theapi/gard_hw/README.md

# GARD STM32 Hardware

The Garden Animal Repellent Device built with an  STM32L053C8Tx and LoRa RFM95 module.

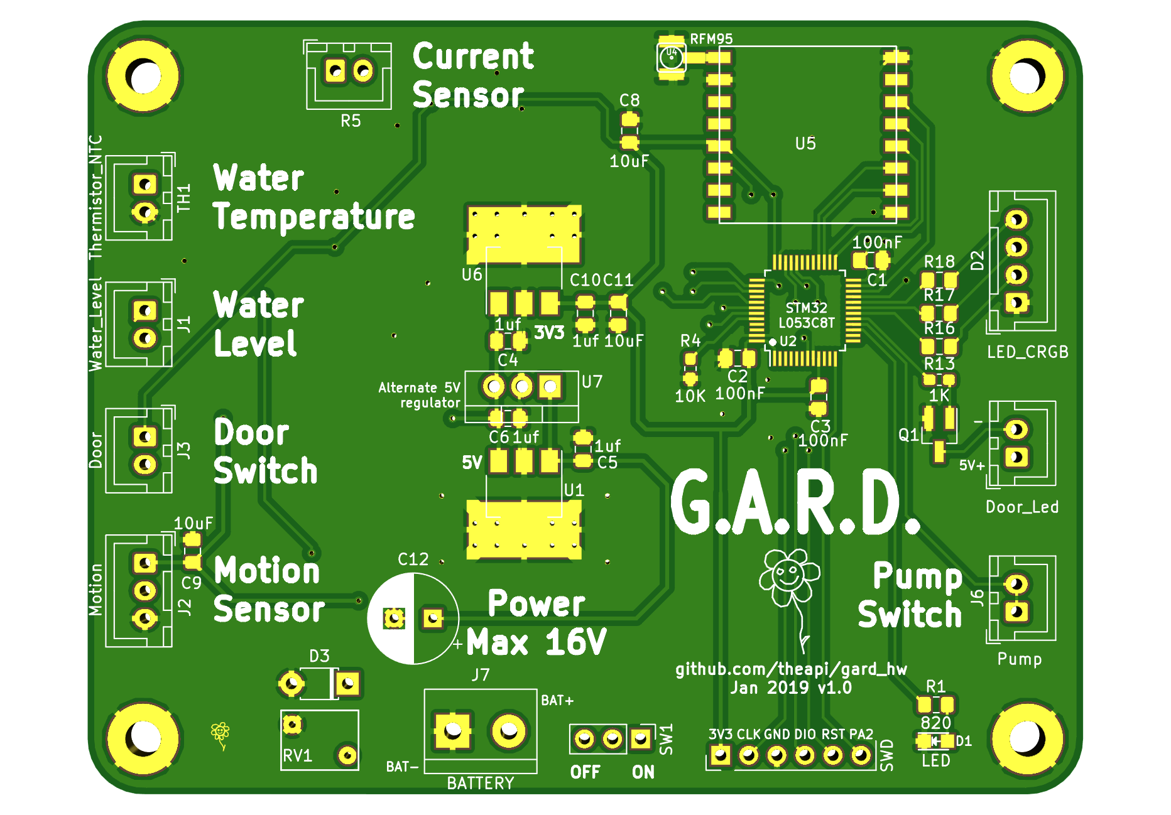
[picture p1: board.png]
