theapi/gard_hw/kicad/stm32l053c.pdf

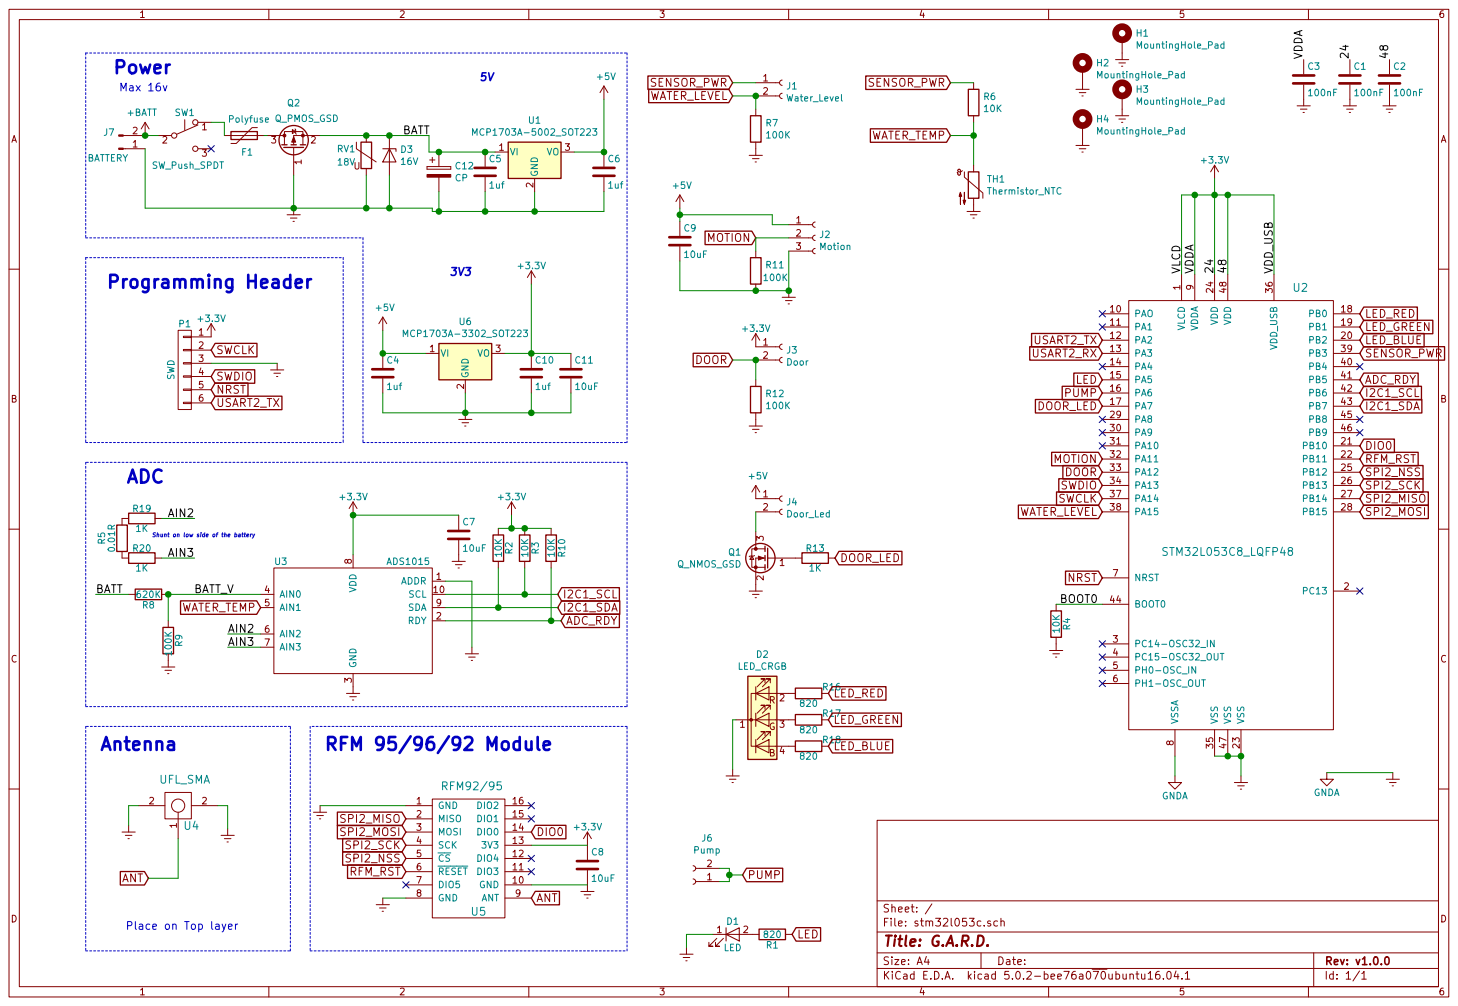
[picture p5: page 1]

9 PAO 10 PB2 20 PA9 30 PB4 40 PA1 11 PB10 21 PA10 31 PB5 41 PA2 12 PB11 22 PA11 32 PB6 42 PA3 13 VSS 23 PA12 33 PB7 43 PA4 14 VDD 24 PA13 34 BOOT0 44 PA5 15 PB12 25 VSS 35 PB8 45 PA6 16 PB13 26 VDD_USB 36 PB9 46 PA7 17 PB14 27 PA14 37 VSS 47 PB0 18 PB15 28 PA15 38 VDD 48 PB1 19 PA8 29 PB3 39 U2 STM32L053C8_LQFP48 10K R4 R1

8 SDA 9 SCL 10 U3 ADS1015 ANT Antenna RFM 95/96/92 Module

Id: 1/1 Title: G.A.R.D. File: stm32l053c.sch Sheet: /

Place on Top layer
