theapi/gard_hw/kicad/solder_mask.pdf

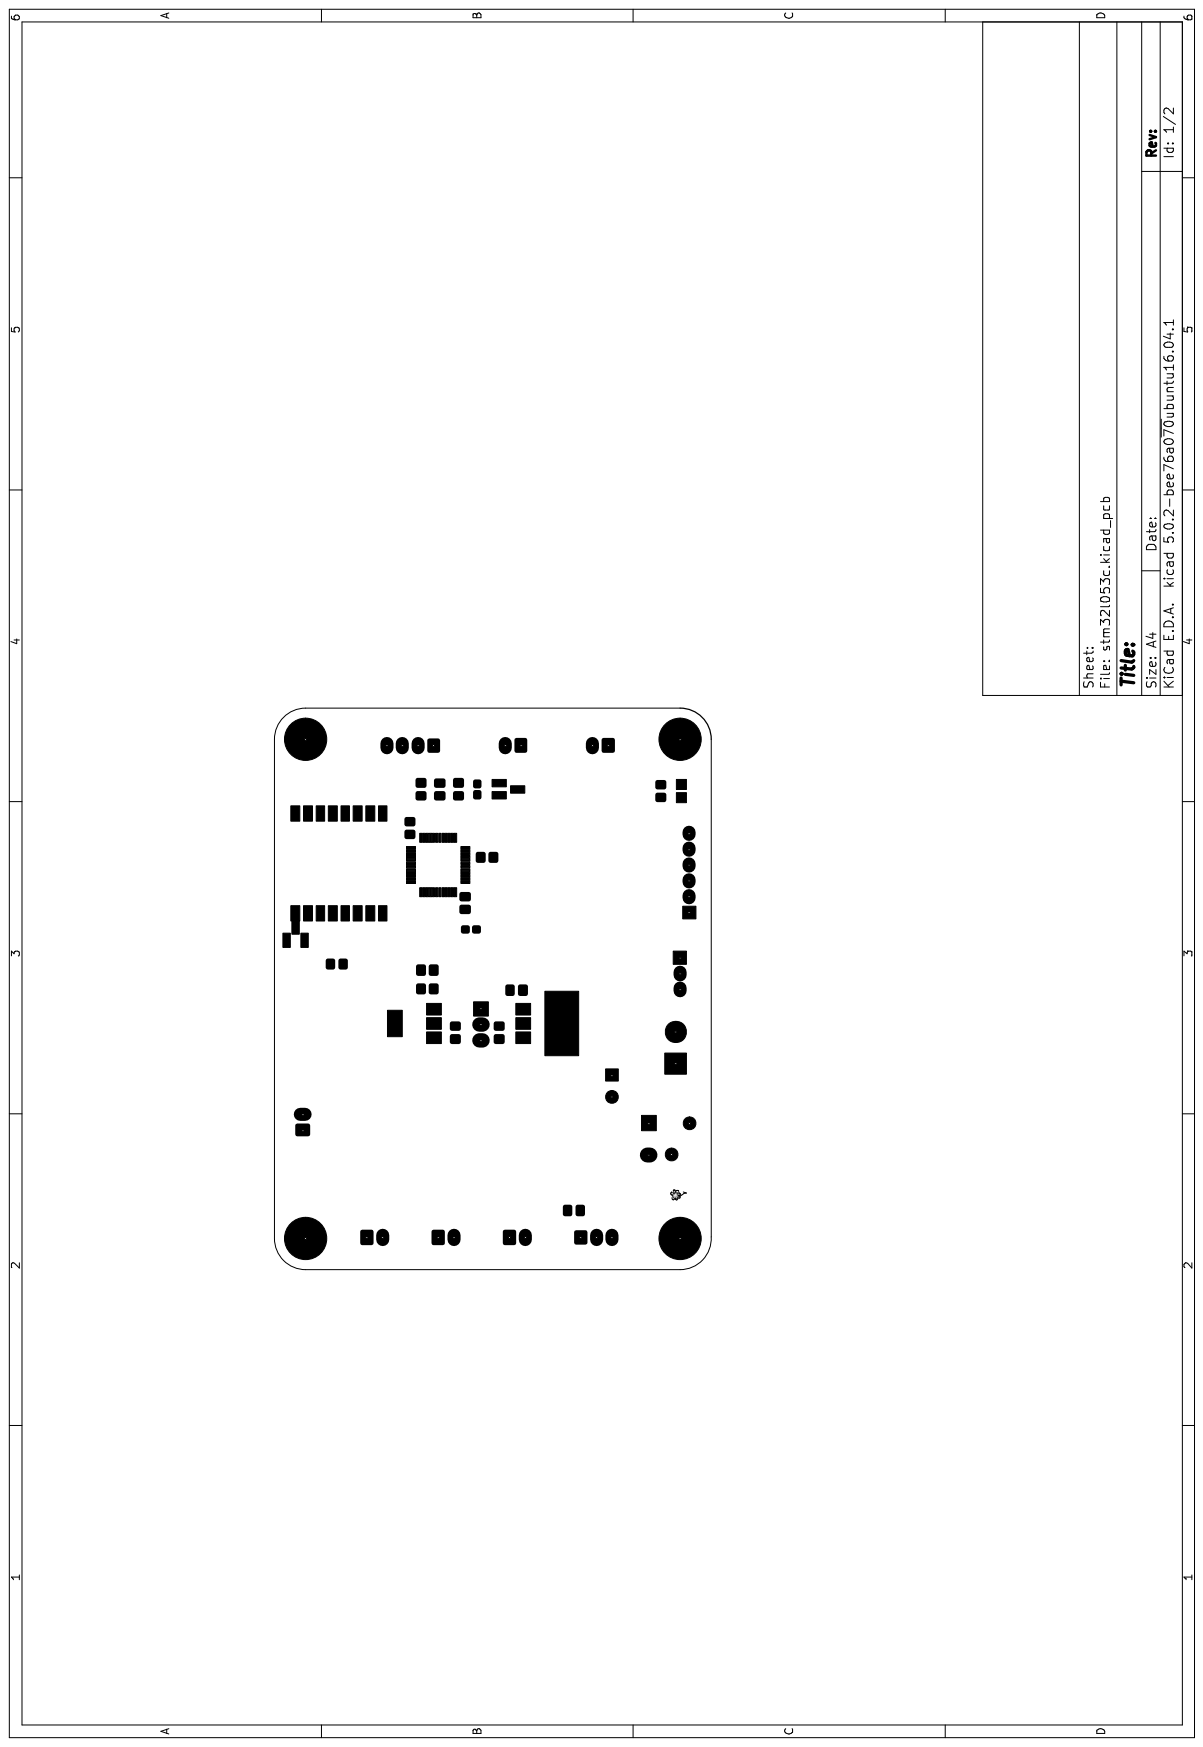
[picture p6: page 1]

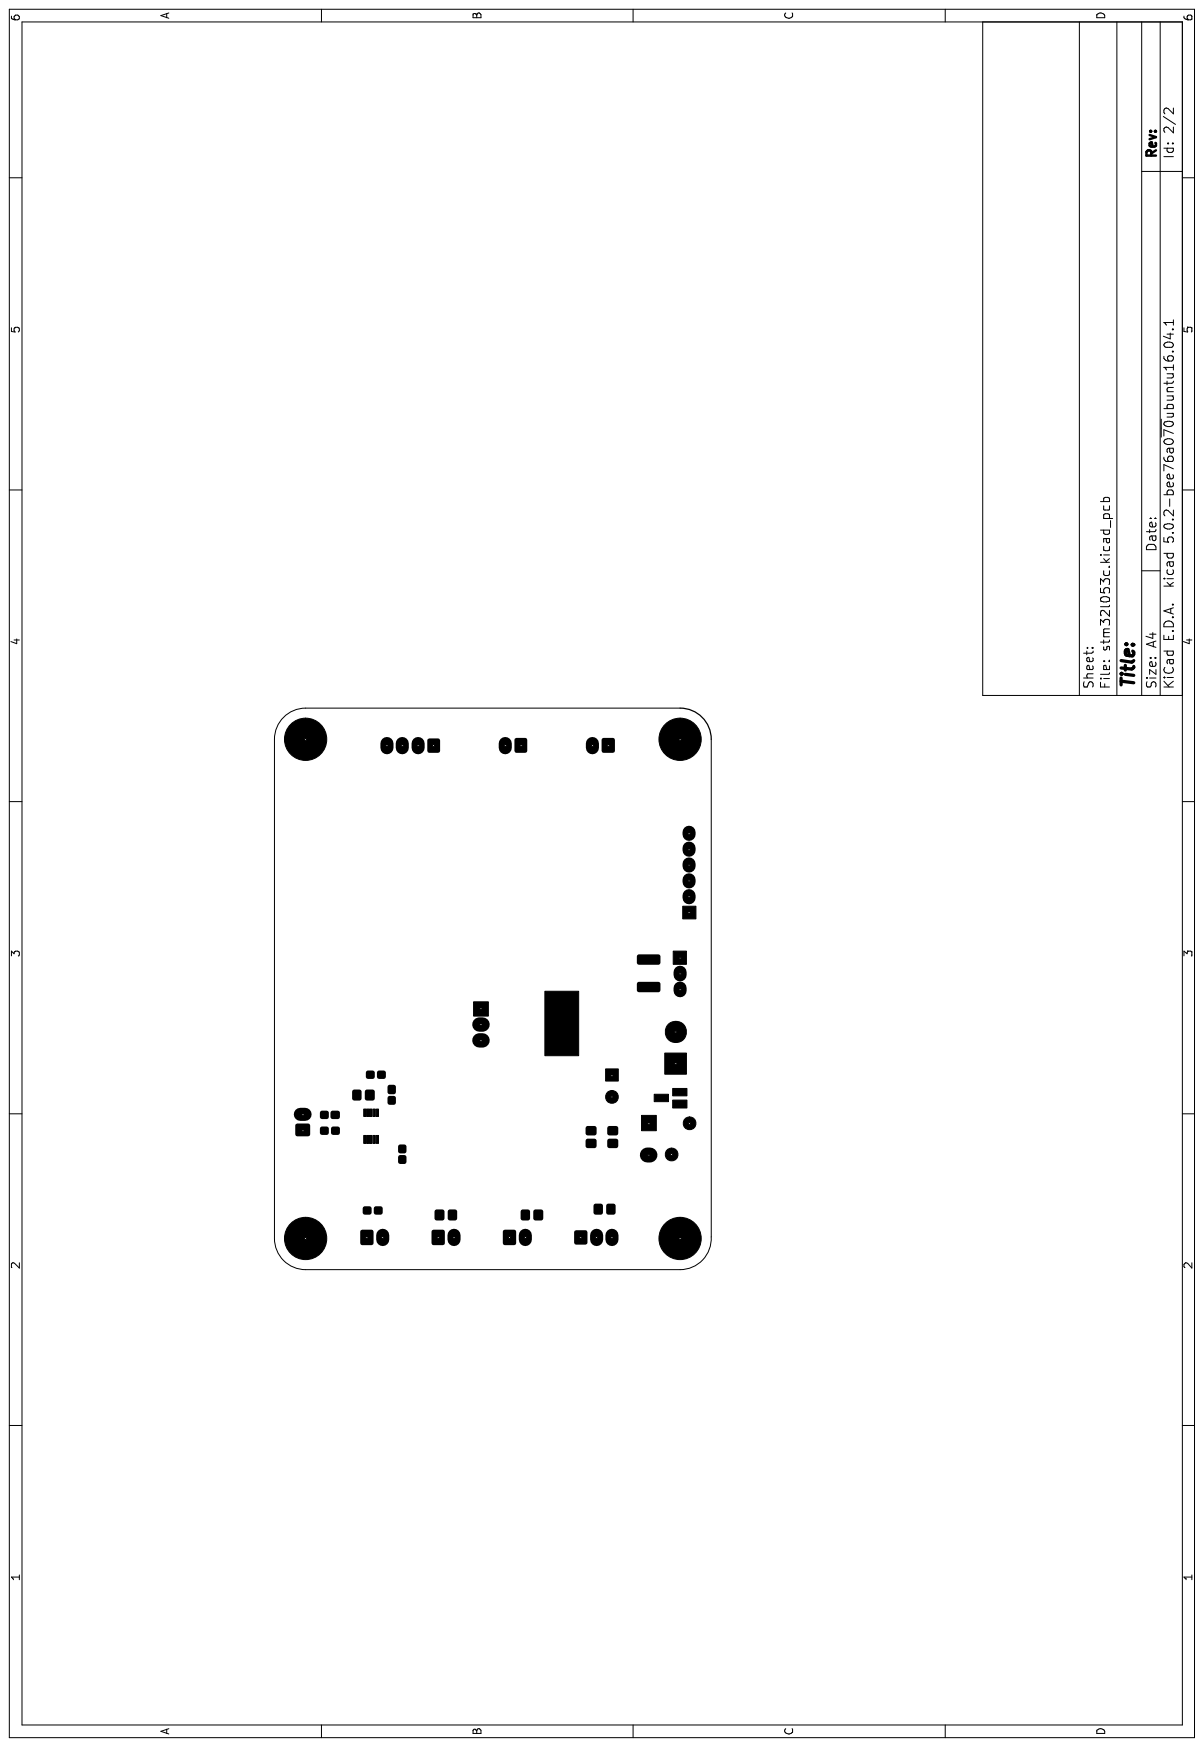
[picture p7: page 2]
