theapi/gard_hw/kicad/stm32l053c.kicad_pcb

## KiCad design kicad/stm32l053c.kicad_pcb (2019-01-03)

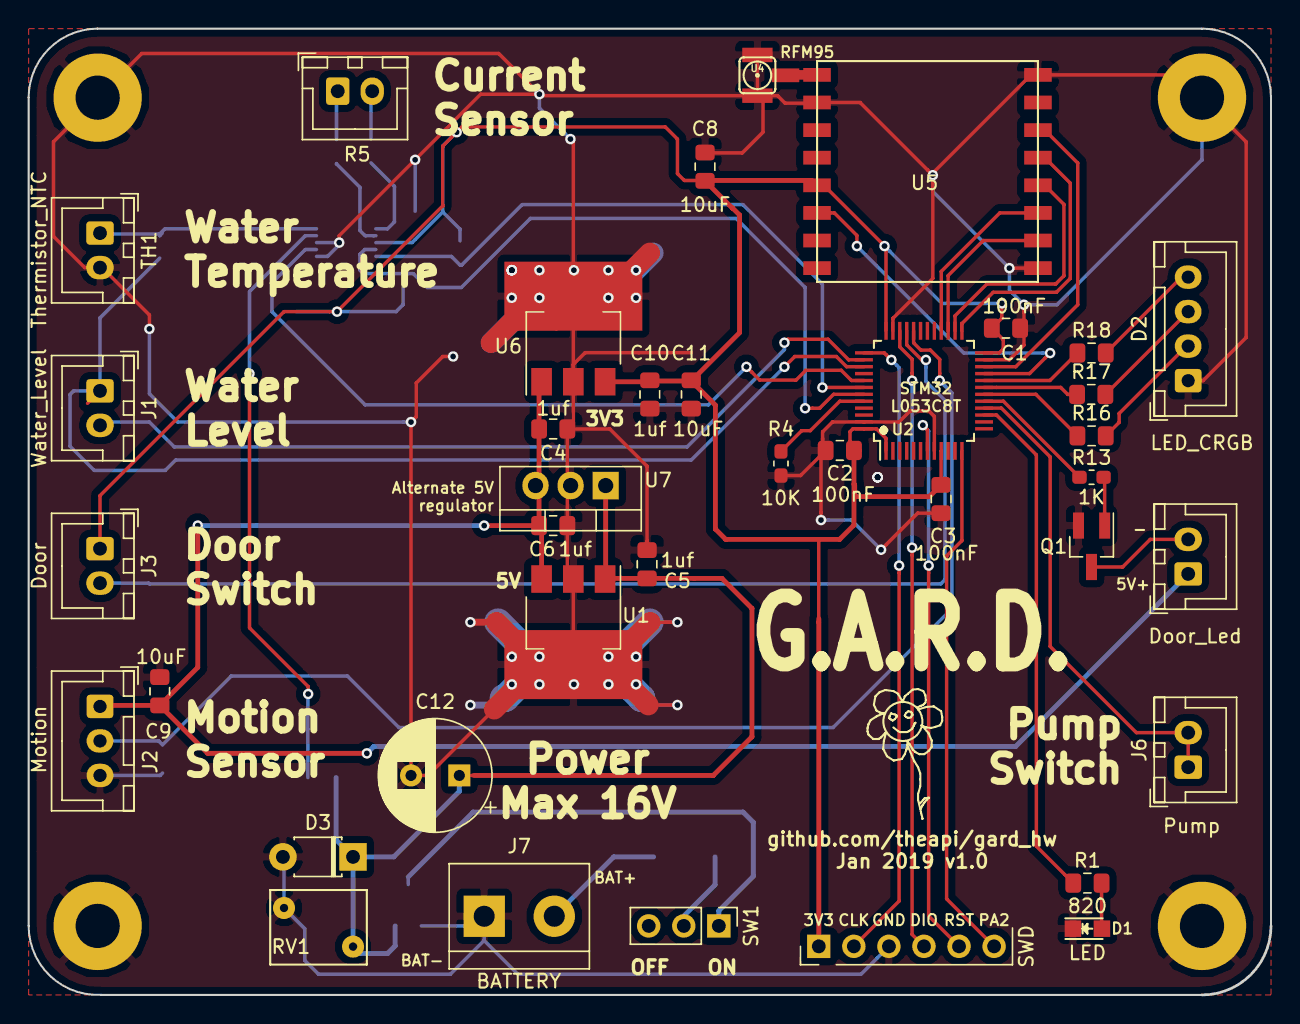
[picture p8: board stm32l053c.kicad_pcb from above]

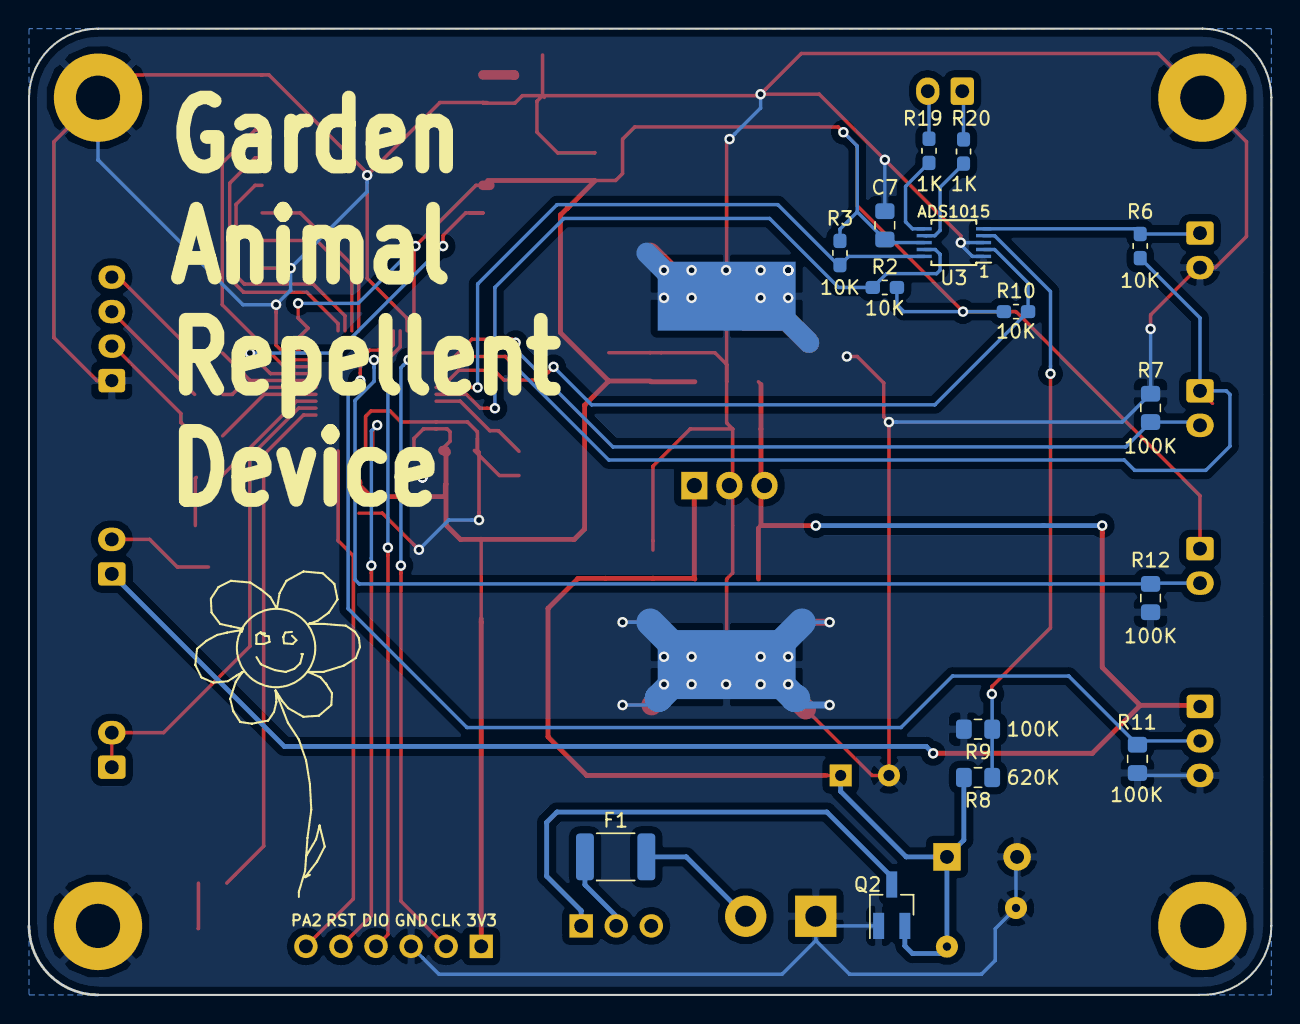
[picture p9: board stm32l053c.kicad_pcb from below]

Board: 2 copper layers, 90.0 x 70.0 mm, 57 parts (15 on the bottom side), 44 nets.

Parts:
C1, C2, C3: 100nF; C_0805_2012Metric_Pad1.15x1.40mm_HandSolder
C4, C5, C6, C10: 1uf; C_0805_2012Metric_Pad1.15x1.40mm_HandSolder
C7, C8, C9, C11: 10uF; C_0805_2012Metric_Pad1.15x1.40mm_HandSolder
C12: CP; CP_Radial_D8.0mm_P3.50mm
D1: LED; LED_0805
D2: LED_CRGB; JST_XH_B04B-XH-A_1x04_P2.50mm_Vertical
D3: 16V; D_T-1_P5.08mm_Horizontal
F1: Polyfuse; R_1812_4532Metric_Pad1.30x3.40mm_HandSolder
H1, H2, H3, H4: MountingHole_Pad; MountingHole_3.2mm_M3_Pad
J1: Water_Level; JST_XH_B02B-XH-A_1x02_P2.50mm_Vertical
J2: Motion; JST_XH_B03B-XH-A_1x03_P2.50mm_Vertical
J3: Door; JST_XH_B02B-XH-A_1x02_P2.50mm_Vertical
J4: Door_Led; JST_XH_B02B-XH-A_1x02_P2.50mm_Vertical
J6: Pump; JST_XH_B02B-XH-A_1x02_P2.50mm_Vertical
J7: BATTERY; TerminalBlock_bornier-2_P5.08mm
P1: SWD; Pin_Header_Straight_1x06_Pitch2.54mm
Q1: Q_NMOS_GSD; SOT-23_Handsoldering
Q2: Q_PMOS_GSD; SOT-23_Handsoldering
R1, R16, R17, R18: 820; R_0805_2012Metric_Pad1.15x1.40mm_HandSolder
R2, R3, R4, R6, R10: 10K; R_0603_1608Metric_Pad1.05x0.95mm_HandSolder
R5: 0.01R; JST_XH_B02B-XH-A_1x02_P2.50mm_Vertical
R7, R9, R11, R12: 100K; R_0805_2012Metric_Pad1.15x1.40mm_HandSolder
R8: 620K; R_0805_2012Metric_Pad1.15x1.40mm_HandSolder
R13, R19, R20: 1K; R_0603_1608Metric_Pad1.05x0.95mm_HandSolder
RV1: 18V; RV_Disc_D7mm_W5.4mm_P5mm
SW1: SW_Push_SPDT; PinHeader_1x03_P2.54mm_Vertical
TH1: Thermistor_NTC; JST_XH_B02B-XH-A_1x02_P2.50mm_Vertical
U1: MCP1703A-5002_SOT223; SOT-223-3_TabPin2_heatsink
U2: STM32L053C8_LQFP48; LQFP-48_7x7mm_Pitch0.5mm
U3: ADS1015; TSSOP-10_3x3mm_P0.5mm
U4: UFL_SMA; coaxial_u.fl-r-smt-1
U5: RFM92/95; RFM92_95_96_98
U6: MCP1703A-3302_SOT223; SOT-223-3_TabPin2_heatsink
U7: LP2954_TO220; TO-220-3_Vertical

Connections:
+3V3: C1.1, C2.1, C3.1, C7.1, C8.1, C10.1, C11.1, J3.1, P1.1, R2.1, R3.1, R10.1, U2.1, U2.9, U2.24, U2.36, U2.48, U3.8, U5.13, U6.3
+5V: C4.1, C6.1, C9.1, J2.1, J4.1, U1.3, U6.1, U7.3
+BATT: F1.2, J7.2
/AIN2: R19.1, U3.6
/AIN3: R20.1, U3.7
/BATT: C5.1, C12.1, D3.1, Q2.2, R8.2, RV1.1, U1.1, U7.1
/BATT_V: R8.1, R9.1, U3.4
/BOOT0: R4.1, U2.44
ADC_RDY: R10.2, U2.41, U3.2
ANT: U4.1, U5.9
DIO0: U2.21, U5.14
DOOR: J3.2, R12.1, U2.33
DOOR_LED: R13.1, U2.17
Earth: C1.2, C2.2, C3.2, C4.2, C5.2, C6.2, C7.2, C8.2, C9.2, C10.2, C11.2, C12.2, D1.1, D2.1, D3.2, H1.1, H2.1, H3.1, H4.1, J2.3, J7.1, P1.3, Q1.2, Q2.1, R4.2, R7.2, R9.2, R11.2, R12.2, RV1.2, TH1.2, U1.2, U2.8, U2.23, U2.35, U2.47, U3.1, U3.3, U4.2, U5.1, U5.8, U5.10, U6.2, U7.2
I2C1_SCL: R3.2, U2.42, U3.10
I2C1_SDA: R2.2, U2.43, U3.9
LED: R1.1, U2.15
LED_BLUE: R18.1, U2.20
LED_GREEN: R17.1, U2.19
LED_RED: R16.1, U2.18
MOTION: J2.2, R11.1, U2.32
NRST: P1.5, U2.7
unnamed: D1.2, R1.2
unnamed: D2.2, R16.2
unnamed: D2.3, R17.2
unnamed: D2.4, R18.2
unnamed: F1.1, SW1.2
unnamed: J4.2, Q1.3
unnamed: Q1.1, R13.2
unnamed: Q2.3, SW1.1
unnamed: R5.2, R19.2
unnamed: R5.1, R20.2
PUMP: J6.1, J6.2, U2.16
RFM_RST: U2.22, U5.6
SENSOR_PWR: J1.1, R6.1, U2.39
SPI2_MISO: U2.27, U5.2
SPI2_MOSI: U2.28, U5.3
SPI2_NSS: U2.25, U5.5
SPI2_SCK: U2.26, U5.4
SWCLK: P1.2, U2.37
SWDIO: P1.4, U2.34
USART2_TX: P1.6, U2.12
WATER_LEVEL: J1.2, R7.1, U2.38
WATER_TEMP: R6.2, TH1.1, U3.5
