theapi/gard_hw/stm32/pump_controller/Src/main.c

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

/* Includes ------------------------------------------------------------------*/
#include "main.h"
#include "adc.h"
#include "i2c.h"
#include "rtc.h"
#include "spi.h"
#include "usart.h"
#include "gpio.h"

/* USER CODE BEGIN Includes */

#include "string.h"
#include "stdio.h"
#include "stdlib.h"

#include "battery.h"
#include "water.h"

/* USER CODE END Includes */

/* USER CODE BEGIN PD */

#define TXBUFFERSIZE 128

/* USER CODE END PD */


void SystemClock_Config(void);
static void MX_NVIC_Init(void);
/* USER CODE BEGIN 0 */

/* Buffer used for debug UART */
char tx_buffer[TXBUFFERSIZE];
uint32_t last_blink = 0;
/* tmp */
uint8_t msg_id = 0;
float water_temperature = 0;

/* USER CODE END 0 */

/**
  * @brief  The application entry point.
  * @retval int
  */
int main(void)
{
  /* MCU Configuration--------------------------------------------------------*/

  /* Reset of all peripherals, Initializes the Flash interface and the Systick. */
  HAL_Init();

  /* Configure the system clock */
  SystemClock_Config();

  /* Initialize all configured peripherals */
  MX_GPIO_Init();
  MX_ADC_Init();
  MX_I2C1_Init();
  MX_RTC_Init();
  MX_SPI2_Init();
  MX_USART2_UART_Init();

  /* Initialize interrupts */
  MX_NVIC_Init();
  /* USER CODE BEGIN 2 */

  HAL_GPIO_WritePin(GPIOB, SENSOR_PWR_Pin, GPIO_PIN_SET);

  HAL_GPIO_WritePin(GPIOA, LED_Pin, GPIO_PIN_SET);
  HAL_GPIO_WritePin(GPIOA, LED_Pin, DOOR_LED_Pin);
  HAL_GPIO_WritePin(GPIOB, LED_RED_Pin, GPIO_PIN_RESET);
  HAL_GPIO_WritePin(GPIOB, LED_GREEN_Pin, GPIO_PIN_RESET);
  HAL_GPIO_WritePin(GPIOB, LED_BLUE_Pin, GPIO_PIN_RESET);

  HAL_GPIO_WritePin(GPIOA, PUMP_Pin, GPIO_PIN_SET);


  /* USER CODE END 2 */

  /* Infinite loop */
  /* USER CODE BEGIN WHILE */
  while (1)
  {
    /* USER CODE END WHILE */

    /* USER CODE BEGIN 3 */


	  uint32_t now = HAL_GetTick();
	  if (now - last_blink >= 1000) {
		  last_blink = now;

		  // Send data to debug UART.
		  water_temperature = WATER_Temperature();
		  char buf[100];
		  gcvt(water_temperature, 6, buf);
		  uint16_t batt = BATTERY_Mv();
			int tx_len = snprintf(
			  tx_buffer,
			  TXBUFFERSIZE,
			  "msg_id:%d, batt:%u, temp:%s\n",
			  msg_id++,
			  batt,
			  buf
			);
			// Blocking UART.
			HAL_UART_Transmit(&huart2, (uint8_t *)tx_buffer, tx_len, 500);


		  HAL_GPIO_TogglePin(GPIOA, LED_Pin);
	  }

	  if (HAL_GPIO_ReadPin(GPIOA, MOTION_Pin)) {
		  HAL_GPIO_WritePin(GPIOB, LED_RED_Pin, GPIO_PIN_SET);
	  } else {
		  HAL_GPIO_WritePin(GPIOB, LED_RED_Pin, GPIO_PIN_RESET);
	  }

	  if (HAL_GPIO_ReadPin(GPIOA, WATER_LEVEL_Pin)) {
		  HAL_GPIO_WritePin(GPIOB, LED_BLUE_Pin, GPIO_PIN_SET);
	  } else {
		  HAL_GPIO_WritePin(GPIOB, LED_BLUE_Pin, GPIO_PIN_RESET);
	  }

	  if (water_temperature > 1600) {
		  HAL_GPIO_WritePin(GPIOB, LED_GREEN_Pin, GPIO_PIN_SET);
	  } else {
		  HAL_GPIO_WritePin(GPIOB, LED_GREEN_Pin, GPIO_PIN_RESET);
	  }

	  if (HAL_GPIO_ReadPin(DOOR_GPIO_Port, DOOR_Pin)) {
		  HAL_GPIO_WritePin(GPIOA, DOOR_LED_Pin, GPIO_PIN_SET);
	  } else {
		  HAL_GPIO_WritePin(GPIOA, DOOR_LED_Pin, GPIO_PIN_RESET);
	  }

//	  HAL_GPIO_WritePin(GPIOB, LED_RED_Pin, GPIO_PIN_SET);
//	  HAL_GPIO_WritePin(GPIOB, LED_GREEN_Pin, GPIO_PIN_RESET);
//	  HAL_GPIO_WritePin(GPIOB, LED_BLUE_Pin, GPIO_PIN_RESET);
//
//	  HAL_Delay(500);
//	  HAL_GPIO_TogglePin(GPIOA, LED_Pin);
//	  HAL_GPIO_TogglePin(GPIOA, DOOR_LED_Pin);
//
//	  HAL_GPIO_WritePin(GPIOB, LED_RED_Pin, GPIO_PIN_RESET);
//	  HAL_GPIO_WritePin(GPIOB, LED_GREEN_Pin, GPIO_PIN_SET);
//	  HAL_GPIO_WritePin(GPIOB, LED_BLUE_Pin, GPIO_PIN_RESET);
//
//	  HAL_Delay(500);
//	  HAL_GPIO_TogglePin(GPIOA, LED_Pin);
//	  HAL_GPIO_TogglePin(GPIOA, DOOR_LED_Pin);
//
//	  HAL_GPIO_WritePin(GPIOB, LED_RED_Pin, GPIO_PIN_RESET);
//	  HAL_GPIO_WritePin(GPIOB, LED_GREEN_Pin, GPIO_PIN_RESET);
//	  HAL_GPIO_WritePin(GPIOB, LED_BLUE_Pin, GPIO_PIN_SET);

  }
  /* USER CODE END 3 */
}

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
