theapi/gard_hw/stm32/pump_controller/pump_controller.ioc

Mcu.UserName=STM32L053C8Tx
PA11.GPIO_Label=MOTION
PA11.Signal=GPIO_Input
PA12.GPIO_Label=DOOR
PA12.Signal=GPXTI12
PA13.Signal=SYS_SWDIO
PA14.Signal=SYS_SWCLK
PA15.GPIO_Label=WATER_LEVEL
PA15.Signal=GPIO_Input
PA2.Signal=USART2_TX
PA3.Signal=USART2_RX
PA5.GPIO_Label=LED
PA5.Signal=GPIO_Output
PA6.GPIO_Label=PUMP
PA6.Signal=GPIO_Output
PA7.GPIO_Label=DOOR_LED
PA7.Signal=GPIO_Output
PB0.GPIO_Label=LED_RED
PB0.Signal=GPIO_Output
PB1.GPIO_Label=LED_GREEN
PB1.Signal=GPIO_Output
PB10.GPIO_Label=DIO0
PB10.Signal=GPXTI10
PB11.GPIO_Label=RFM_RESET
PB11.Signal=GPIO_Output
PB12.GPIO_Label=SPI2_CS
PB12.Signal=GPIO_Output
PB13.Signal=SPI2_SCK
PB14.Signal=SPI2_MISO
PB15.Signal=SPI2_MOSI
PB2.GPIO_Label=LED_BLUE
PB2.Signal=GPIO_Output
PB3.GPIO_Label=SENSOR_PWR
PB3.Signal=GPIO_Output
PB5.GPIO_Label=ADC_RDY
PB5.Signal=GPXTI5
PB6.Signal=I2C1_SCL
PB7.Signal=I2C1_SDA
