theapi/gard_hw/(commit log)

2018-12-26 Start of pin assignment
    [stm32l053c.sch]
2018-12-26 Start of layout
    [stm32l053c.kicad_pcb, stm32l053c.sch]
2018-12-27 5V regulator before the 3V3 one
    [stm32l053c.sch]
2018-12-27 Two voltage regulator layout
    [stm32l053c.kicad_pcb, stm32l053c.sch]
2018-12-27 Solder mask for the ADS1015
    [stm32l053c.kicad_pcb, stm32l053c.sch]
2018-12-28 Power layout
    [stm32l053c.kicad_pcb, stm32l053c.sch]
2018-12-28 Changed the overvoltage protection
    [stm32l053c.kicad_pcb, stm32l053c.sch]
2018-12-28 Reassign ADC pins
    [stm32l053c.kicad_pcb, stm32l053c.sch]
2018-12-29 Moved the ADC
    [stm32l053c.kicad_pcb]
2018-12-29 All connected
    [stm32l053c.kicad_pcb, stm32l053c.sch]
2018-12-29 Power switch
    [stm32l053c.kicad_pcb, stm32l053c.sch]
2018-12-31 Altenate 5V regulator
    [stm32l053c.kicad_pcb, stm32l053c.sch]
2018-12-31 Heatsinking for the 5V regulator
    [stm32l053c.kicad_pcb, stm32l053c.sch]
2018-12-31 Board image
2018-12-31 Antenna datasheet
2018-12-31 Name on the board
    [stm32l053c-B.Cu.gbl, stm32l053c-B.Mask.gbs, stm32l053c-B.SilkS.gbo, stm32l053c-Edge.Cuts.gm1, stm32l053c-F.Cu.gtl, stm32l053c-F.Mask.gts, stm32l053c-F.SilkS.gto, stm32l053c.drl]
2019-01-01 Solder mask print
2019-01-03 Heatsinked vreg
    [stm32l053c.kicad_pcb, stm32l053c.sch]
2019-01-03 Removed old gerbers
    [stm32l053c-B.Cu.gbl, stm32l053c-B.Mask.gbs, stm32l053c-B.SilkS.gbo, stm32l053c-Edge.Cuts.gm1, stm32l053c-F.Cu.gtl, stm32l053c-F.Mask.gts, stm32l053c-F.SilkS.gto, stm32l053c.drl]
2019-01-03 Ordered from JLCPCB
    [stm32l053c-B.Cu.gbl, stm32l053c-B.Mask.gbs, stm32l053c-B.SilkS.gbo, stm32l053c-Edge.Cuts.gm1, stm32l053c-F.Cu.gtl, stm32l053c-F.Mask.gts, stm32l053c-F.SilkS.gto, stm32l053c-NPTH.drl]
2019-01-12 Blinking leds
    [pump_controller Debug.cfg]
2019-01-13 Cap value
    [stm32l053c.sch]
2019-01-13 ADS1015 ADC
2019-01-16 Door led controlled by door switch
2019-01-22 Battery mV calibration
2019-01-29 Water temperature
2019-01-30 Steinhart–Hart equation
2019-01-30 Allow for negative temperatures
2019-01-31 Water temperature as a float
