theapi/gard_hw/(notices)

Notices in the files:
stm32/pump_controller/Src/main.c:
COPYRIGHT(c) 2018 STMicroelectronics
(C) COPYRIGHT STMicroelectronics *****END OF FILE
